dcmwijaya/Aquaponic-pH-Control-Monitoring-with-Type-2-Fuzzy-Method-Based-on-IoT-Bot/Assets/Documentation/Report/File Sidang Skripsi.pdf

Universitas Pembangunan Nasional “Veteran” Jawa Timur

# “ Kendali dan Monitoring pH Air Akuaponik Berbasis IoT Dengan Metode Fuzzy Type-2 ”

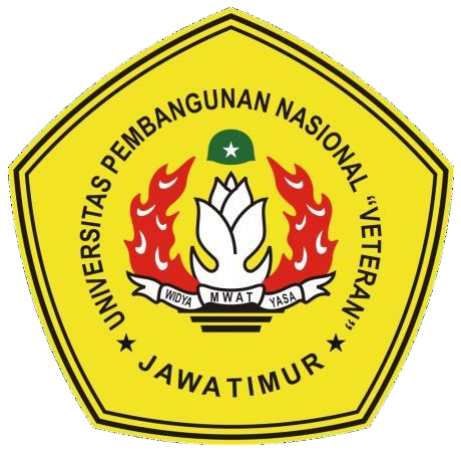
[picture p12: figure]

### Sidang Tugas Akhir (Skripsi)

Nama : Devan Cakra Mudra Wijaya

NPM : 18081010013

S1-Informatika / F. Ilmu Komputer Tahun 2022

### Dosen Pembimbing :

Dr. Basuki Rahmat, S.Si, MT •

Eva Yulia Puspaningrum, S.Kom, M.Kom •

# Latar Belakang

Covid-19 yang berlangsung di tahun 2020 menyebabkan perekonomian masyarakat global semakin menurun. Hal tersebut sangat mengkhawatirkan terutama dari sisi ketahanan pangan, sehingga masyarakat harus bergegas untuk menyelesaikan permasalahan tersebut secara mandiri. Budidaya dengan sistem akuaponik merupakan sebuah solusi alternatif yang dapat dilakukan saat ini, namun pengendalian pH sangat sulit untuk diatur yang terkadang dapat menyebabkan gagal panen. Oleh karena itu, setelah dianalisa lebih lanjut maka penulis memutuskan untuk membuat sistem pengendalian dan pemantauan keasaman air akuaponik berbasis IoT (Internet of Things) terintegrasi bot telegram dan menggunakan mikrokontroler jenis ESP32 sebagai inovasi baru. Metodologi yang diterapkan pada penelitian ini menggunakan RAD (Rapid Application Development) dengan gabungan tiga metode dalam penciptaan sistem yaitu : On-Off Controller, Fuzzy Type-2, dan Eksperimen.

# Perumusan Masalah

1. Bagaimana cara mengkategorikan derajat pH air pada sistem akuaponik berdasarkan sensor pH dan kertas lakmus ?
2. Bagaimana perancangan sistem yang memanfaatkan mikrokontroler dan internet untuk melakukan pengendalian serta pemantauan dalam jarak yang jauh ?
3. Bagaimana cara menerapkan metode Fuzzy Type-2 dalam pembuatan sistem kendali dan monitoring pH air pada sistem akuaponik ?
4. Bagaimana pengaruh pH asam terhadap pertumbuhan tanaman sawi Pakcoy dan ikan lele ?
5. Bagaimana cara mengintegrasikan perangkat mikrokontroler terhadap bot telegram ?
6. Bagaimana cara mengendalikan pH air agar dapat menjaga kondisi yang ideal dalam budidaya tanaman sawi Pakcoy dan ikan lele ?

# Batasan Masalah

1. Aplikasi terbatas untuk pengendalian dan pemantauan derajat pH air terhadap pertumbuhan tanaman sawi Pakcoy dan ikan lele pada sistem akuaponik secara realtime.
2. Media yang diperlukan untuk pengendalian dan pemantauan jarak jauh yaitu menggunakan teknologi Internet of Things.
3. Rockwool dibutuhkan sebagai media tanam hidroponik sawi Pakcoy, sedangkan akuarium dibutuhkan sebagai media akuakultur ikan lele.
4. Mikrokontroler ESP32 sebagai alat untuk memerintah sensor dan aktuator pada sistem.
5. Variabel input Fuzzy Type-2 yang ada dalam penelitian ini yaitu pHair, sedangkan variabel output-nya yaitu RelaypHup dan RelaypHdown.

# Tujuan

1. Untuk mendapatkan nilai pH air dari sensor secara realtime.
2. Untuk membandingkan tingkat keakurasian serta mengukur galat selisih dan juga galat sistematis yang ada pada sistem.
3. Untuk keperluan budidaya sayur hidroponik rumahan khususnya sawi Pakcoy dengan diiringi hobi memelihara ikan yang menggunakan teknologi IoT (Internet of Things).
4. Untuk membuat sistem pengendalian dan pemantauan keasaman air akuaponik yang mudah digunakan oleh pengguna aplikasi (user friendly) kapanpun dan dimanapun berada.
5. Untuk membuat inovasi yang unik berupa perancangan sistem yang bertujuan untuk menyelesaikan masalah ketahanan pangan di masa pandemi COVID-19 dalam skala kecil (konsumsi pribadi).

# Manfaat

1. Bagi Peneliti, kegiatan ini memberikan dorongan positif untuk menerapkan ilmu yang telah

dipelajari semasa kuliah khususnya di bidang sistem cerdas robotika (sistem kontrol).

2. Bagi Masyarakat Umum, dapat menjadi referensi unik dalam pembudidayaan sayur dan

ikan melalui sistem akuaponik yang berbasis teknologi.

3. Bagi Pembaca, dapat mempelajari dan memahami konsep rancang bangun aplikasi berbasis

Internet of Things dan juga dapat mempermudah pemahaman terkait penggunaan bot

telegram.

# Penelitian Terdahulu

1. Mailoa dkk, 2020. “ Sistem Kontrol dan Monitoring Kadar pH Air pada Sistem Akuaponik Berbasis NodeMCU ESP8266 Menggunakan Telegram ” : Peneliti membuat prototipe hardware dan software (bot telegram) agar dapat mengontrol dan memantau kadar pH air pada sistem akuaponik.
2. Alam dkk, 2020. “ Sistem Pengendali pH Air dan Pemantauan Lingkungan Tanaman Hidroponik menggunakan Fuzzy Logic Controller berbasis IoT ” : Peneliti membuat prototipe hardware dan software (blynk) untuk mengontrol pH air dan memonitor lingkungan tanaman hidroponik berbasis Internet of Things (IoT).
3. Yunior dkk, 2019. “ Sistem Monitoring Kualitas Air pada Budidaya Perikanan Berbasis IoT dan Manajemen Data ” : Peneliti membuat prototipe hardware dan software (website dan mobile application) untuk mengantisipasi penyakit dan bakteri yang ada pada air kolam budidaya dengan meningkatkan kualitas air (pH, oksigen terlarut, suhu, dan kekeruhan).
4. Haqim dkk, 2018. “ Perancangan Web Monitoring dan Kontrolling Aquaponic Untuk Budidaya Ikan Lele Berbasis Internet of Things ” : Peneliti membuat prototipe hardware dan software (website) agar dapat memantau kondisi pH dan suhu air sewaktu-waktu. Selain itu juga untuk mengontrol pemberian pakan ikan dari jarak yang jauh.

1

2
3

4

# Sejarah Fuzzy

Tahun 1930-an | Tahun 1965 | Tahun 1975 | Tahun 1998
Logika Infinity diperkenalkan oleh Łukasiewicz dan Tarski | Logika Fuzzy Type-1 diperkenalkan oleh Lotfi Aliasker Zadeh | Logika Fuzzy Type-2 diperkenalkan oleh Lotfi Aliasker Zadeh | Teori Logika Fuzzy diperjelas lagi oleh Karnik-Mendel, sehingga menjadi populer

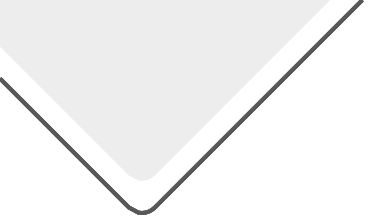
[picture p13: figure]

# Cara Kerja Fuzzy Type-2

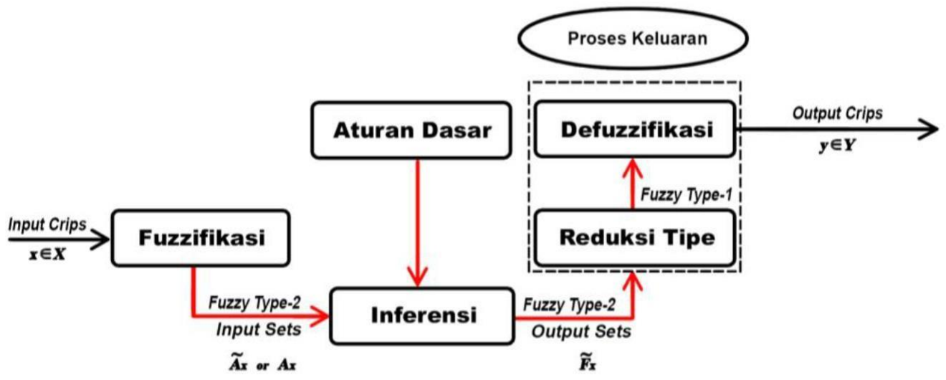
[picture p14: figure]

Fuzzifikasi = proses memetakan input crips menjadi nilai keanggotaan
linguistik (UMF dan LMF).
Inferensi | = proses | memetakan | basis
aturan | logika | pada | hasil
fuzzifikasi.

Reduksi Tipe = proses mengubah himpunan
fuzzy | type-2 | menjadi
himpunan fuzzy type-1.

Defuzzifikasi = proses untuk mengolah hasil reduksi tipe menjadi nilai tegas (crips) sebagai hasil akhir (output).

# Istilah Dalam Logika Fuzzy

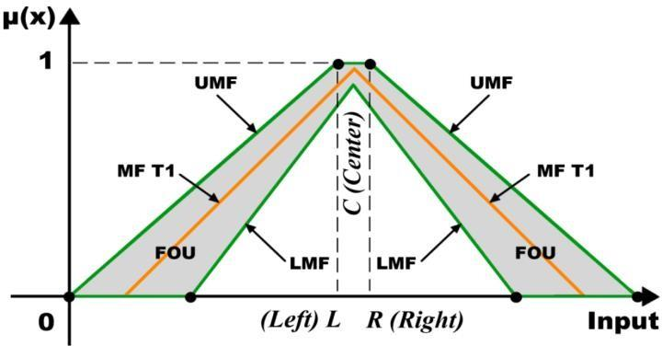
[picture p15: figure]

Variabel | = berupa input atau output Fuzzy.

Himpunan Fuzzy = kumpulan data berupa
| linguistik dan numeris.
Himpunan Crips | = kumpulan data berupa nilai tegas (1/0).
Domain | = range nilai pada suatu himpunan Fuzzy.

Himpunan Semesta = range nilai pada variabel Fuzzy.
Fungsi Keanggotaan = pemetaan | titik | input
Fuzzy berdasarkan kurva.
FOU | = wilayah terbatas.
UMF | = himpunan atas.
LMF | = himpunan bawah.

# Representasi Kurva

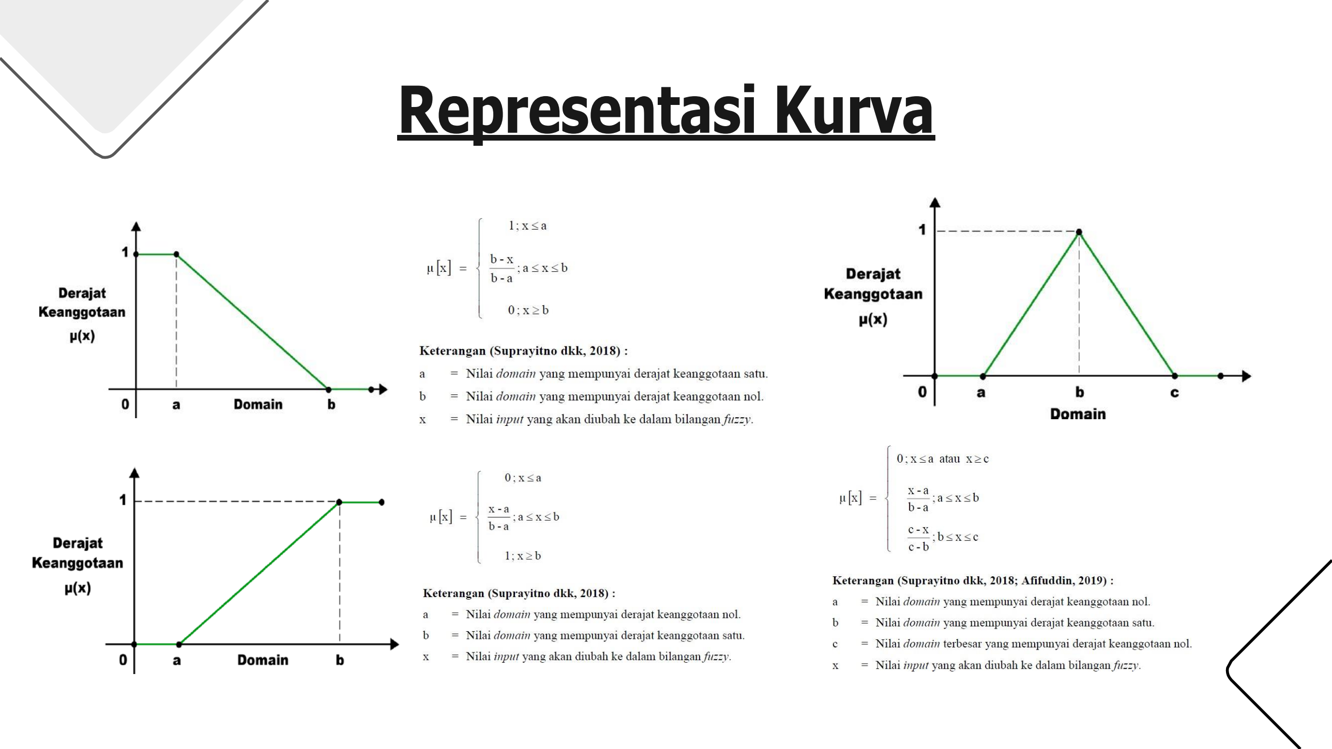
[picture p16: page 11]

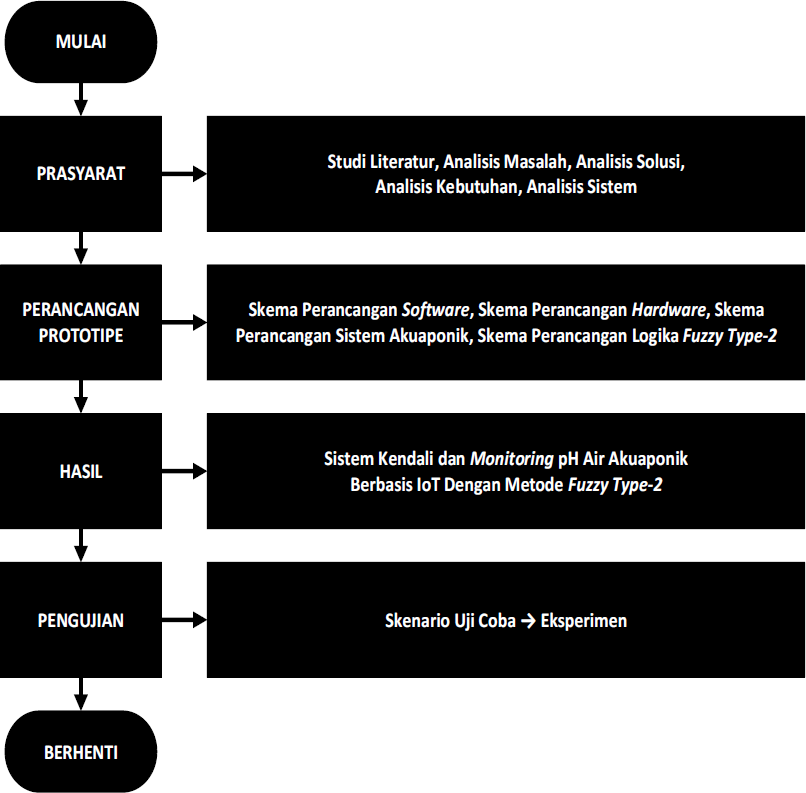
[picture p17: figure]

# Metode Penelitian

Metodologi yang digunakan pada penelitian ini berupa RAD (Rapid Application Development). Hal tersebut
mempunyai | 4 | tahapan | dalam
pelaksanaannya | yaitu | prasyarat
(requirement), perancangan prototipe (prototyping), hasil (output), dan pengujian (testing). Hal tersebut dapat anda lihat pada Gambar di samping.

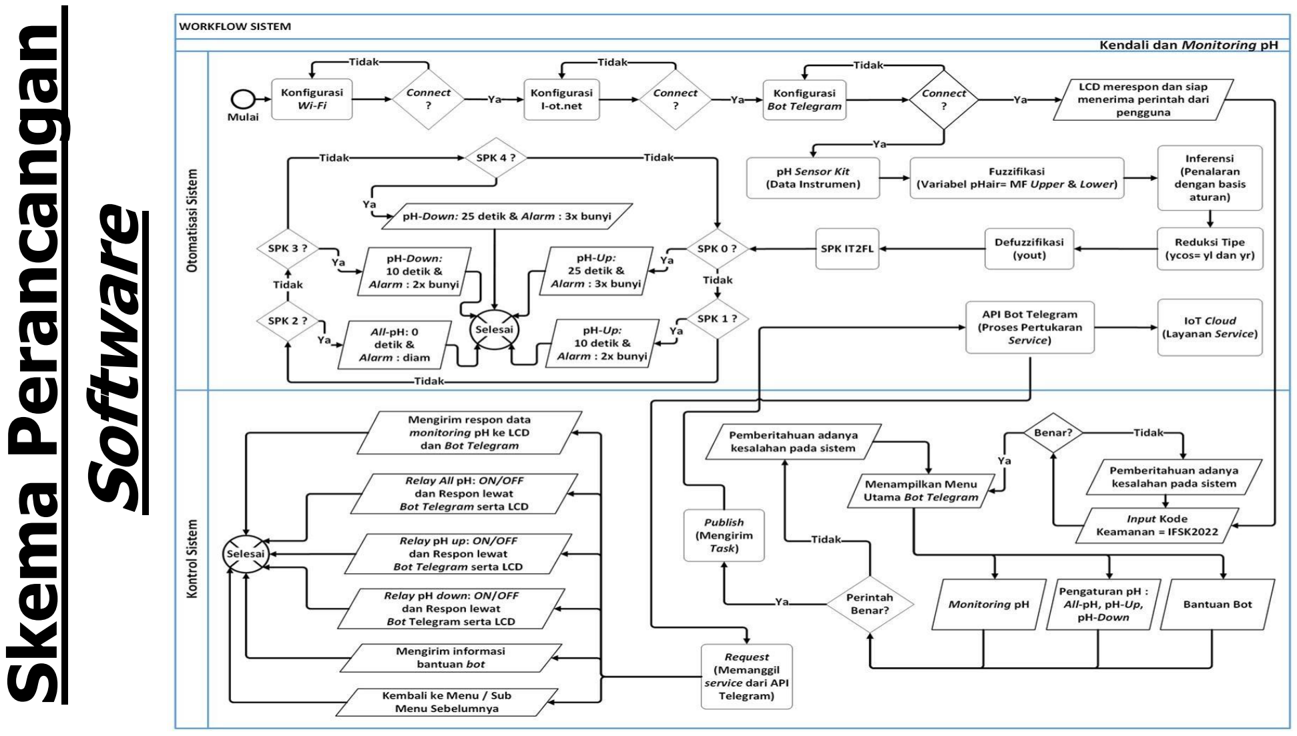
[picture p18: page 13]

# Skema Perancangan

# Software

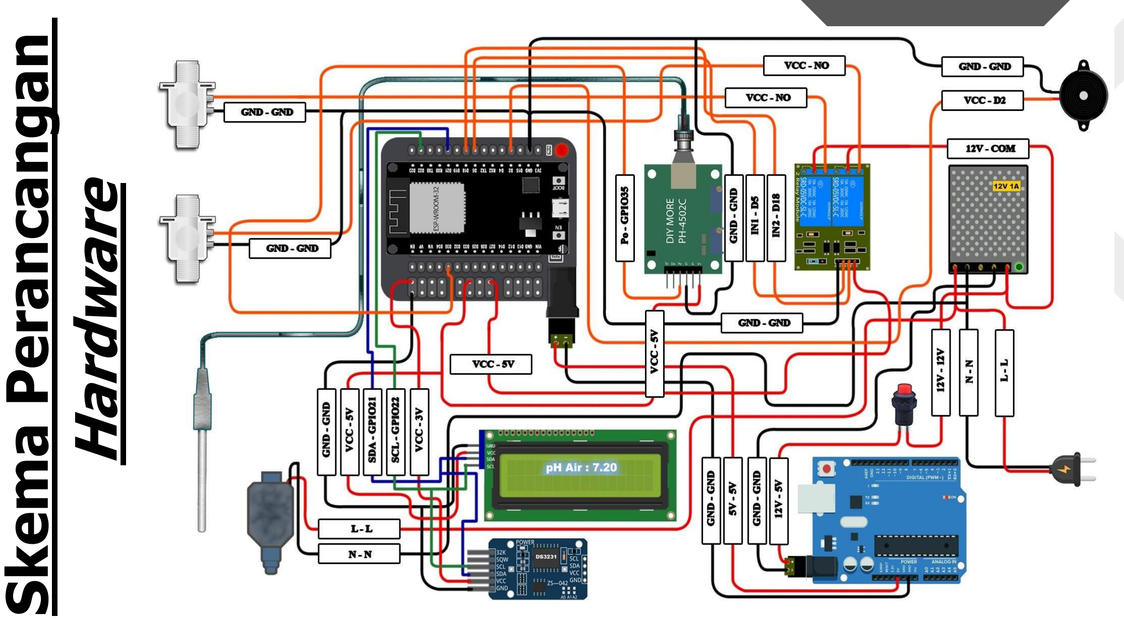
[picture p19: page 14]

# Skema Perancangan

# Hardware

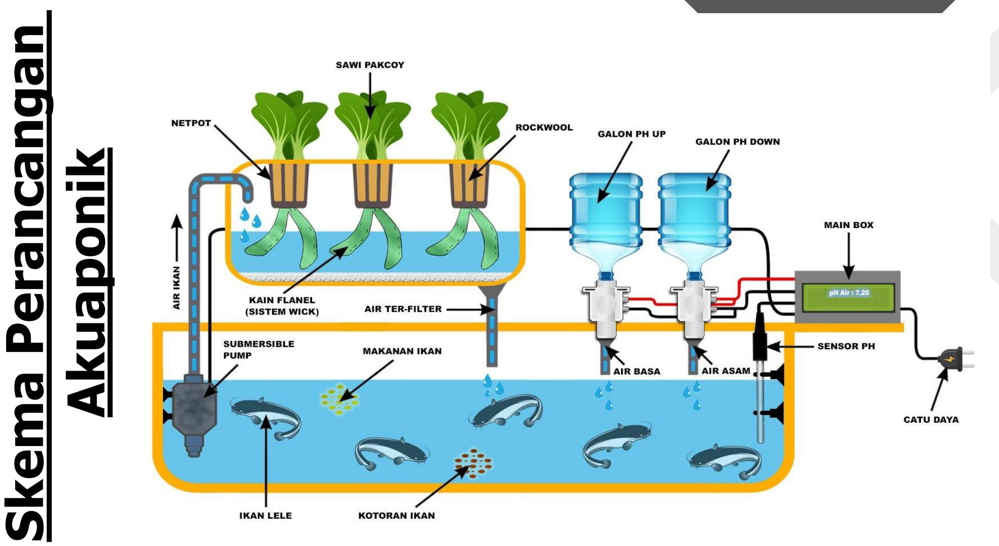
[picture p20: page 15]

# Skema Perancangan

# Akuaponik

# Skema Perancangan Logika Fuzzy Type-2

Pada penelitian ini, logika fuzzy type-2 yang diterapkan berupa IT2FL yang dipakai penulis untuk sistem kendali dan monitoring pH air akuaponik. Hal tersebut dapat mengendalikan pH air sehingga mencapai kondisi yang ideal dalam budidaya tanaman sawi Pakcoy dan ikan lele. Adapun tahapan-tahapan dalam perancangan logika fuzzy type-2 yaitu dapat dilakukan sebagai berikut ini :

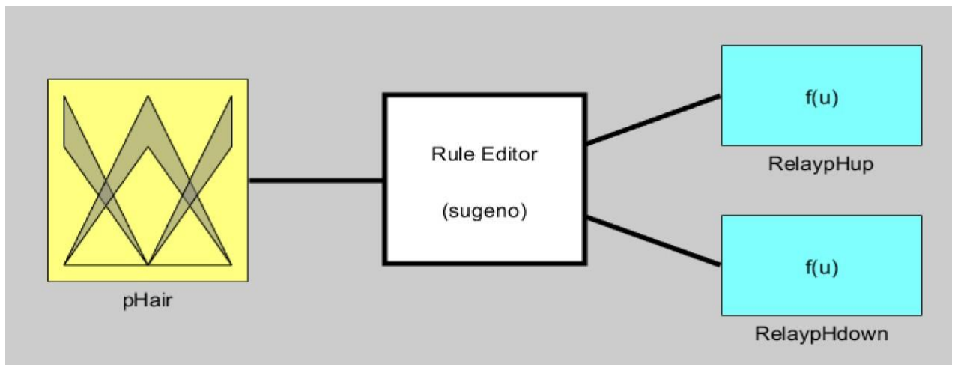
[picture p21: figure]

Fuzzifikasi

Model FIS yang digunakan oleh
penulis yaitu SIMO (Single Input Multi Output). Variabel input yang dipakai dalam penelitian ini hanya variabel pHair, sedangkan variabel
output | yang | dipakai | dalam
penelitian ini ada dua yaitu variabel RelaypHup dan RelaypHdown.

# Fuzzifikasi : Variabel Input

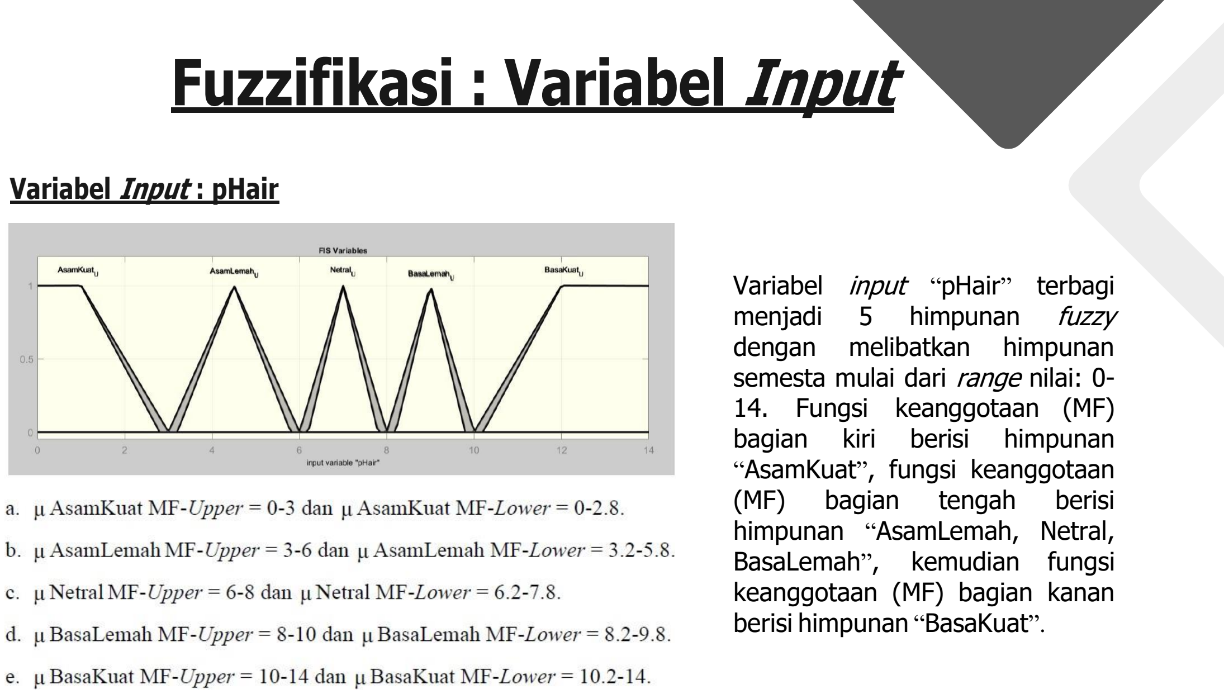
[picture p22: page 17]

Variabel Input : pHair

Variabel input “pHair” terbagi
menjadi | 5 | himpunan | fuzzy
dengan | melibatkan | himpunan
semesta mulai dari range nilai: 0-
14. Fungsi keanggotaan (MF)
bagian | kiri | berisi | himpunan
“AsamKuat”, fungsi keanggotaan
(MF) | bagian | tengah | berisi
himpunan “AsamLemah, Netral, BasaLemah”, kemudian fungsi keanggotaan (MF) bagian kanan berisi himpunan “BasaKuat”.

# Fuzzifikasi: MF Variabel Input

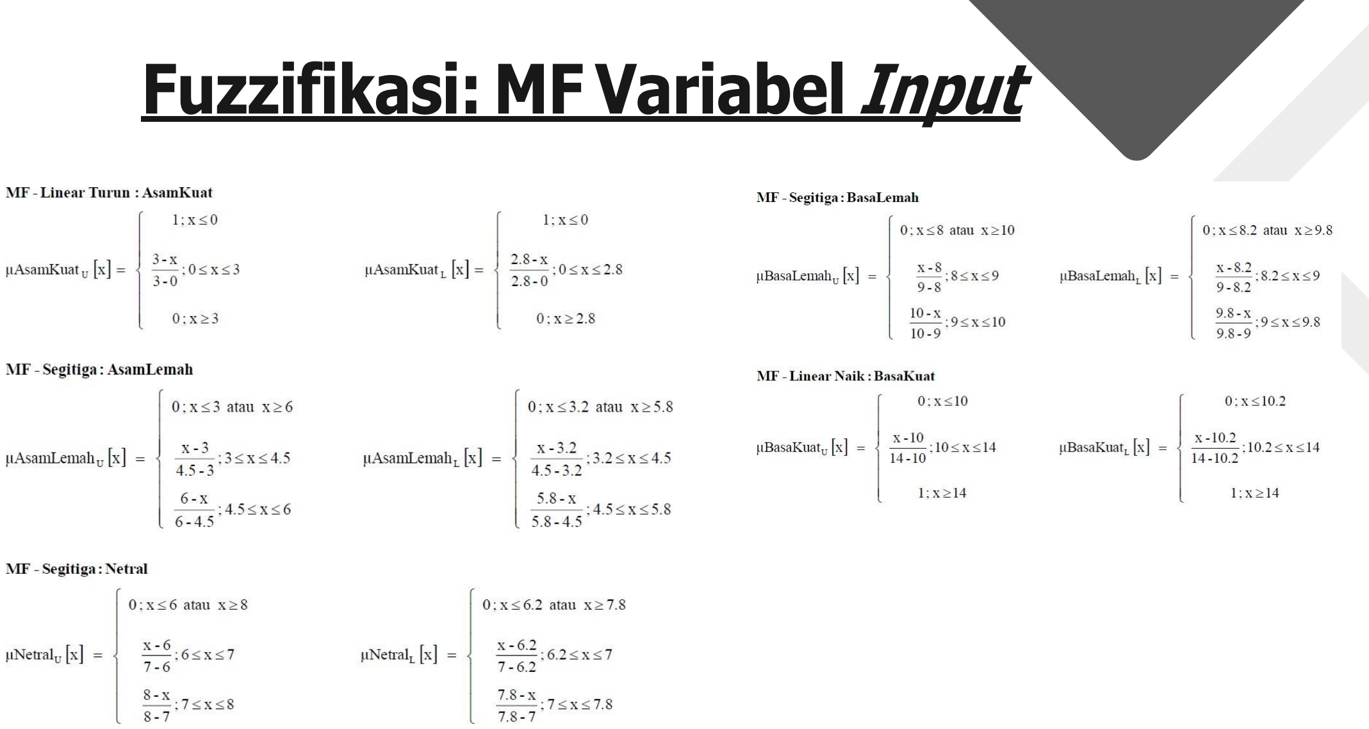
[picture p23: page 18]

# Fuzzifikasi : Variabel Output

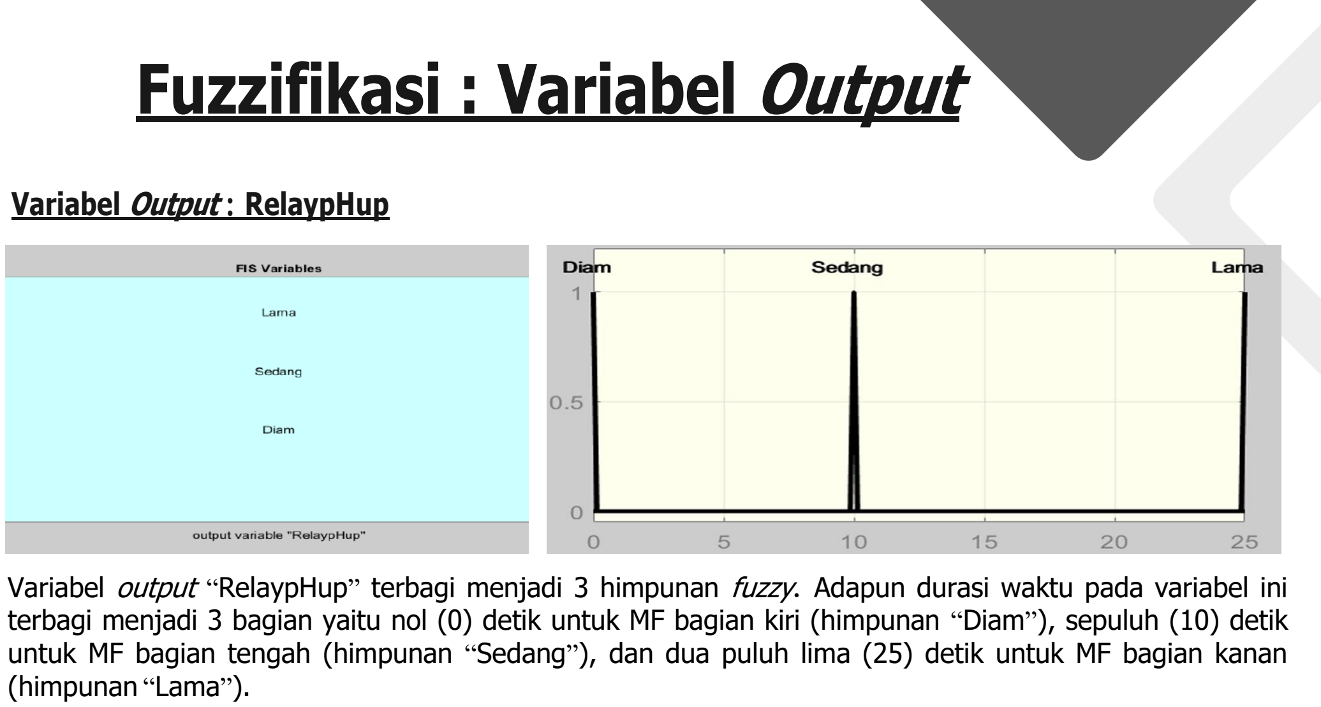
[picture p24: page 19]

Variabel Output : RelaypHup

Variabel output “RelaypHup” terbagi menjadi 3 himpunan fuzzy. Adapun durasi waktu pada variabel ini terbagi menjadi 3 bagian yaitu nol (0) detik untuk MF bagian kiri (himpunan “Diam”), sepuluh (10) detik untuk MF bagian tengah (himpunan “Sedang”), dan dua puluh lima (25) detik untuk MF bagian kanan (himpunan “Lama”).

# Fuzzifikasi : Variabel Output

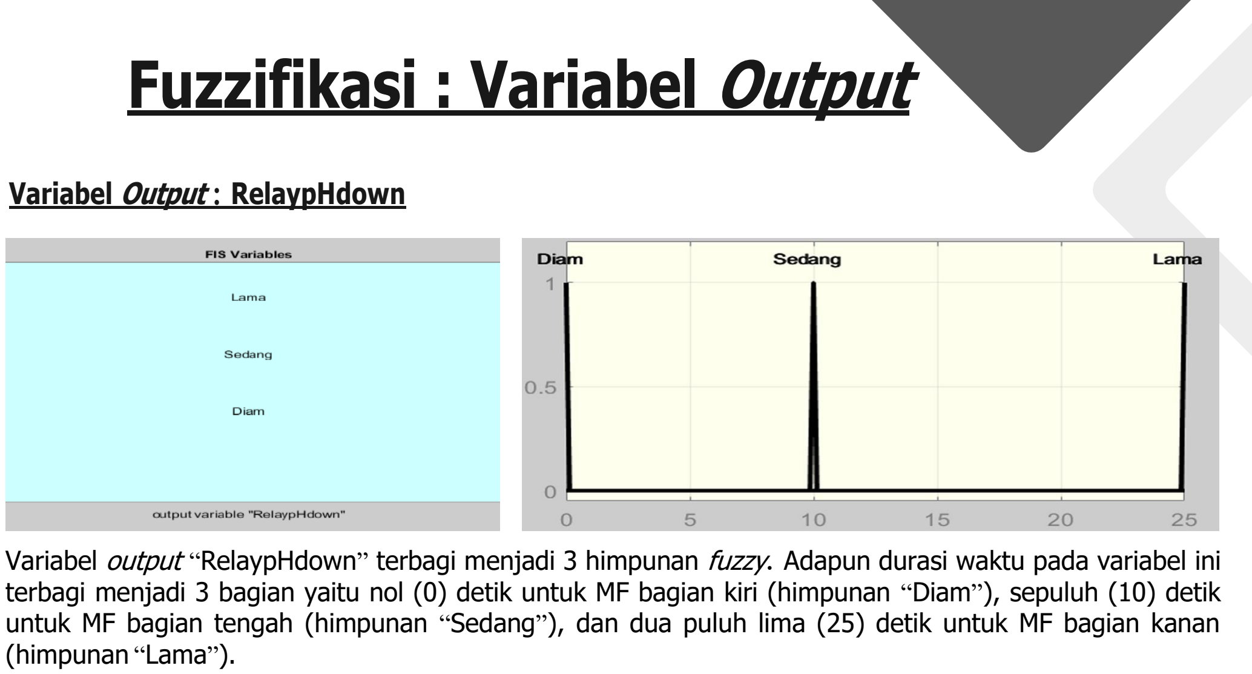
[picture p25: page 20]

Variabel Output : RelaypHdown

Variabel output “RelaypHdown” terbagi menjadi 3 himpunan fuzzy. Adapun durasi waktu pada variabel ini terbagi menjadi 3 bagian yaitu nol (0) detik untuk MF bagian kiri (himpunan “Diam”), sepuluh (10) detik untuk MF bagian tengah (himpunan “Sedang”), dan dua puluh lima (25) detik untuk MF bagian kanan (himpunan “Lama”).

# Inferensi Fuzzy Type-2

Pada inferensi ini, pengambilan keputusan pada sistem didasari oleh ketetapan-ketetapan berikut ini :

1. Nilai output sama dengan nol (0), maka perintah yang wajib dilakukan yaitu RelaypHup : ON lama (25 detik) dan RelaypHdown : OFF.
2. Nilai output sama dengan satu (1), maka perintah yang wajib dilakukan yaitu RelaypHup : ON sedang (10 detik) dan RelaypHdown : OFF.

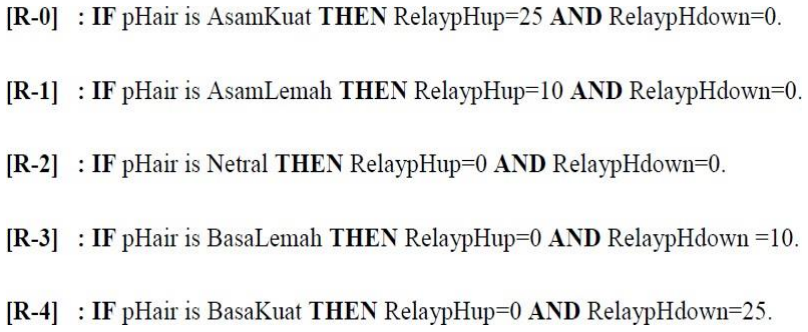
[picture p26: figure]

3. Nilai output sama dengan dua (2), maka perintah yang wajib dilakukan yaitu RelaypHup : OFF dan RelaypHdown : OFF.
4. Nilai output sama dengan tiga (3), maka perintah yang wajib dilakukan yaitu RelaypHup : OFF dan RelaypHdown : ON sedang (10 detik).
5. Nilai output sama dengan empat (4), maka perintah yang wajib dilakukan yaitu RelaypHup : OFF dan RelaypHdown :ON lama (25 detik).

Pada penelitian ini, variabel pHair diketahui ada 5 himpunan fuzzy yang setelah melalui proses penalaran mendapatkan 5 kombinasi aturan (rule) yang dapat diterapkan pada
sistem. | Inferensi | dalam | penelitian | ini
menggunakan Metode Sugeno Orde-Nol
dengan | penalaran | monoton, | karena
proposisi | terhitung | tunggal | di | bagian
antesedennya.

# Reduksi Tipe dan Defuzzifikasi Fuzzy Type-2

Pada penelitian ini, penulis menggunakan jenis reduksi tipe : Center of Set (KM-Algorithm). Bentuk umum dari Center of Set Typereduction untuk sistem kontrol dapat anda lihat pada persamaan berikut.

Adapun rumus deffuzifikasi yang ada pada IT2FL ditunjukkan pada persamaan berikut.

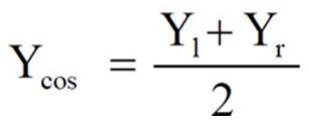
[picture p27: figure]
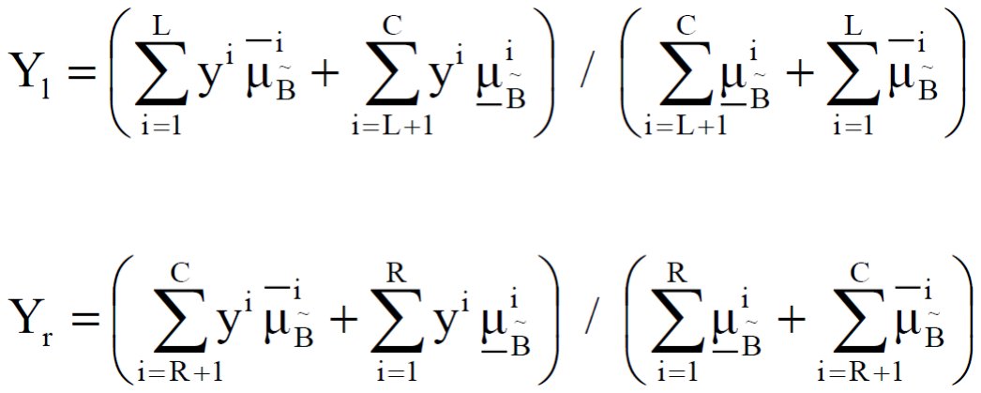
[picture p28: figure]

# Contoh Manual : Fuzzifikasi Fuzzy Type-2

Diketahui sensor pH milik Pak Jojo menunjukkan nilai pH sebesar 8.5, maka bagaimana cara menentukan hasil fuzzy ?

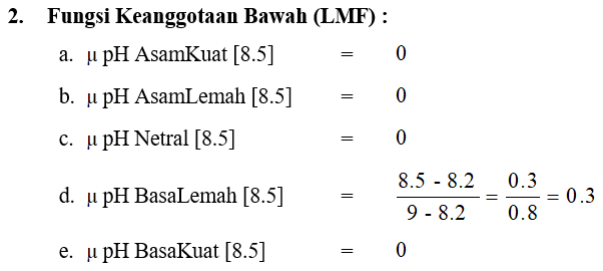
[picture p29: figure]
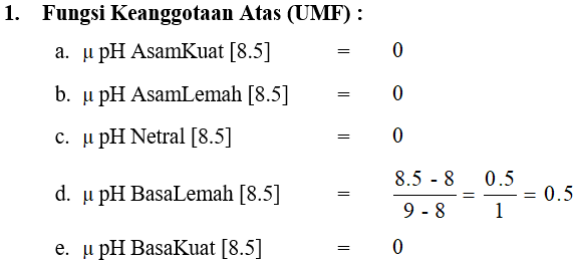
[picture p30: figure]

# Contoh Manual : Inferensi Fuzzy Type-2

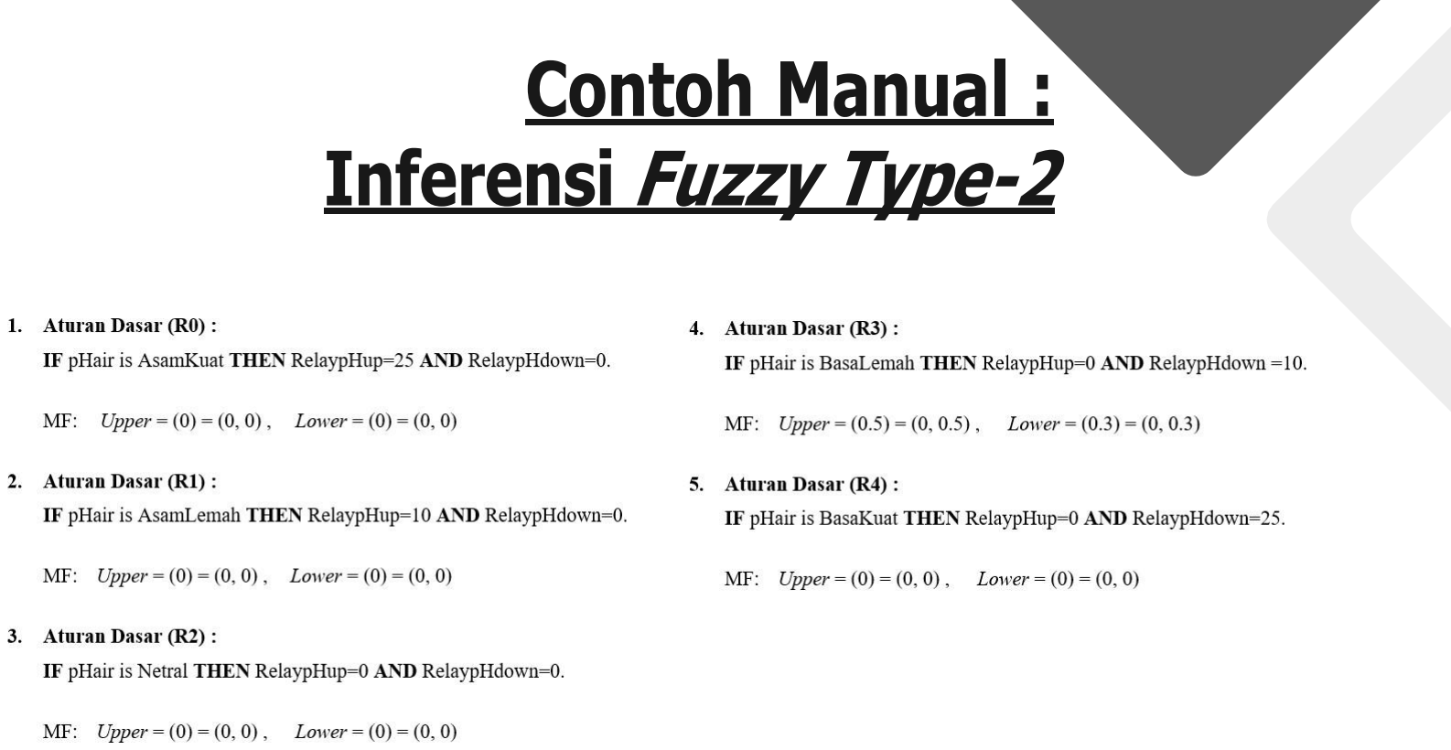
[picture p31: page 24]

# Contoh Manual : Reduksi Tipe Fuzzy Type-2

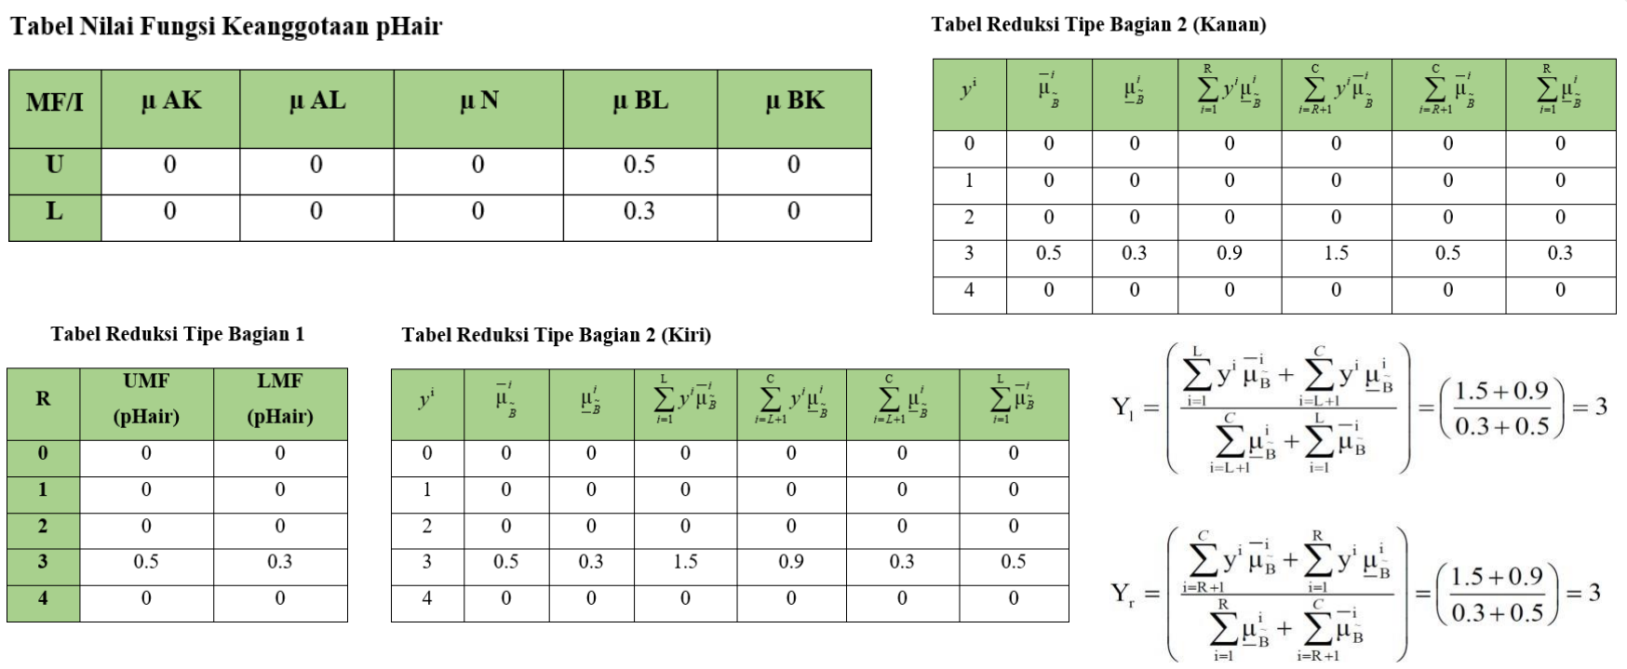
[picture p32: figure]

# Contoh Manual : Defuzzifikasi Fuzzy Type-2

Selanjutnya dapat dilakukan proses defuzzifikasi dengan cara mengambil nilai rata-rata (average) dari himpunan interval kiri (yl) dan kanan (yr). Berikut merupakan contoh penyelesaian defuzzifikasi :

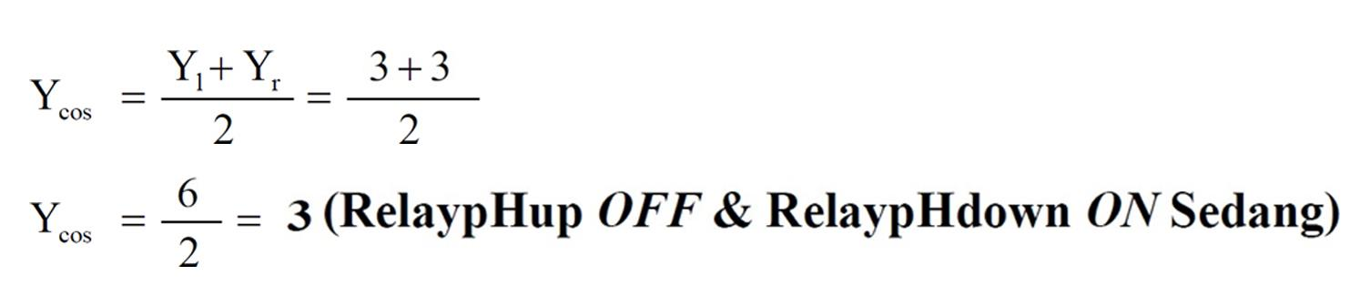
[picture p33: figure]

# Integrasi : Internet of Things

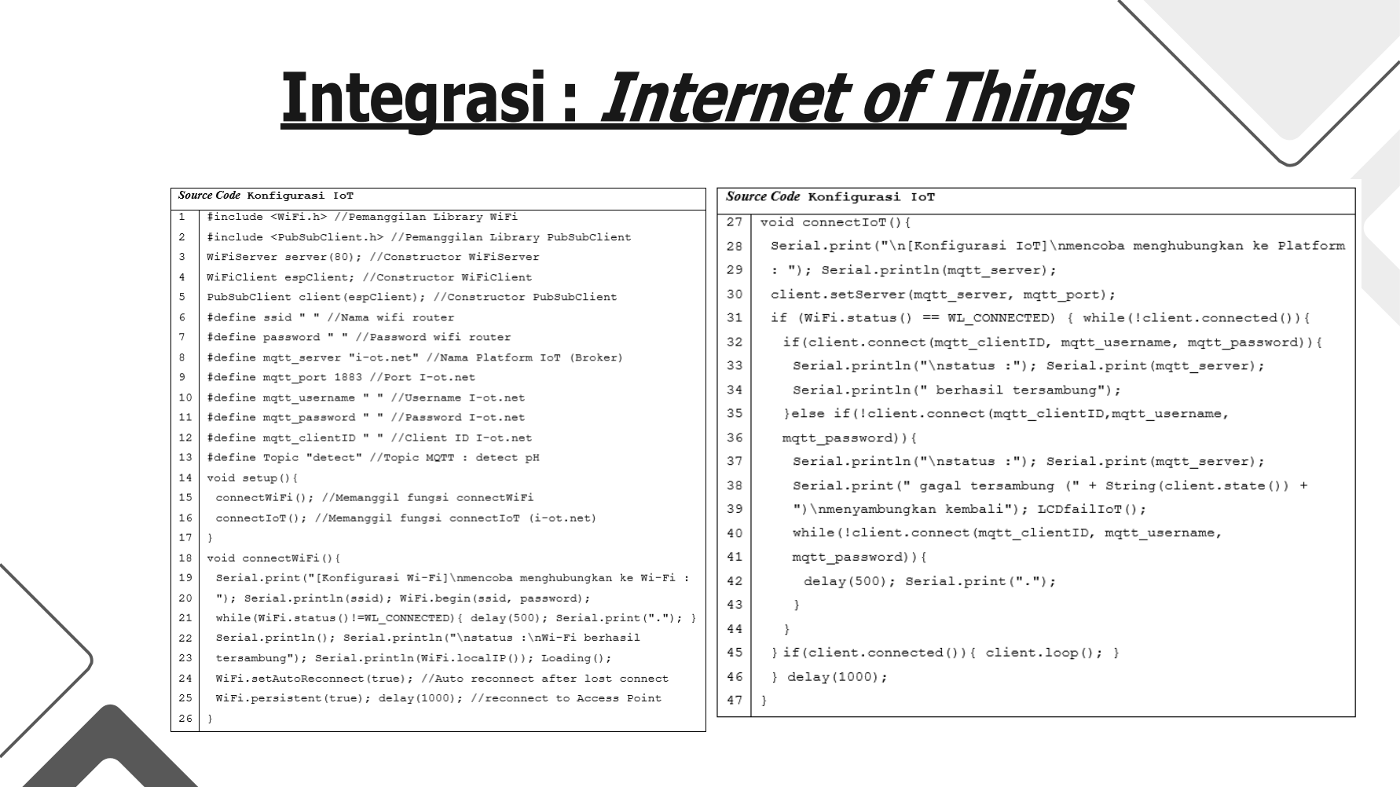
[picture p34: page 27]

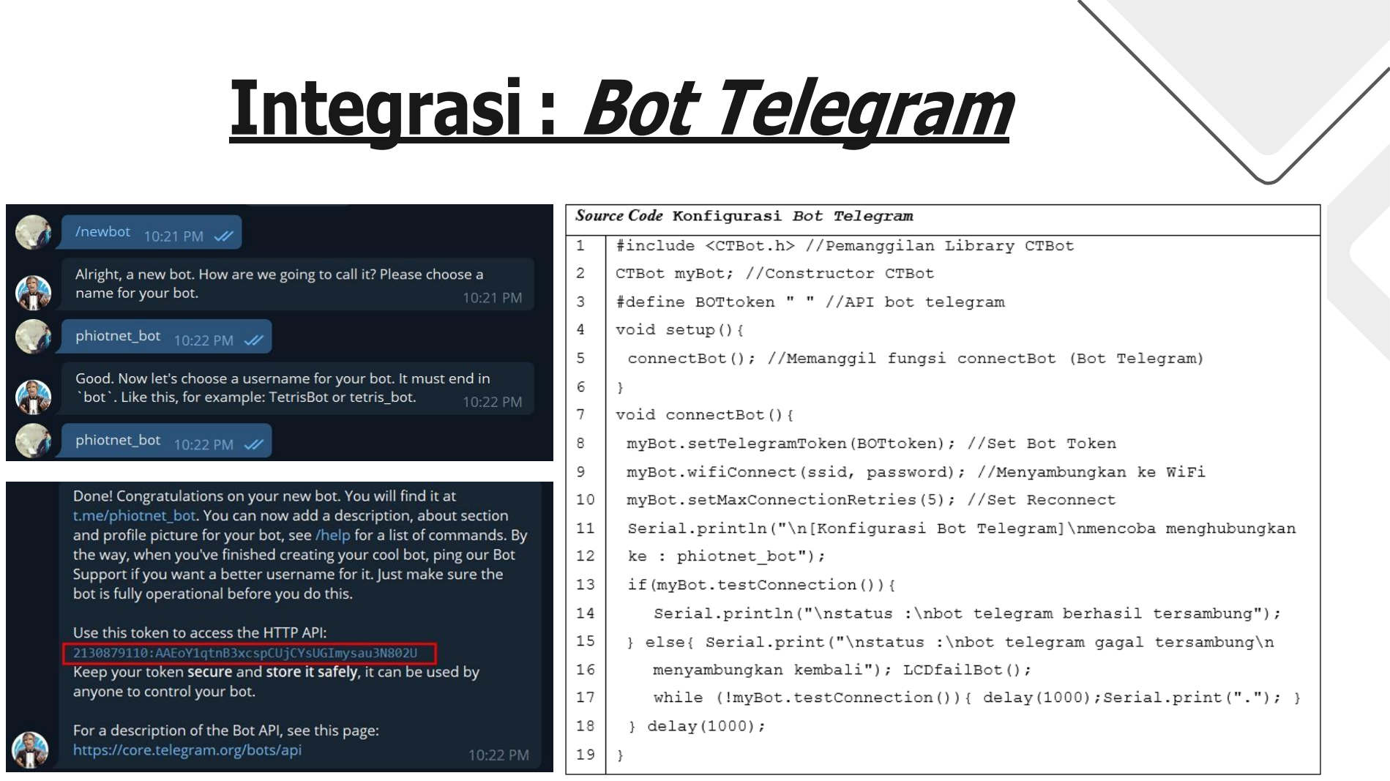
[picture p35: figure]
Integrasi : Bot Telegram

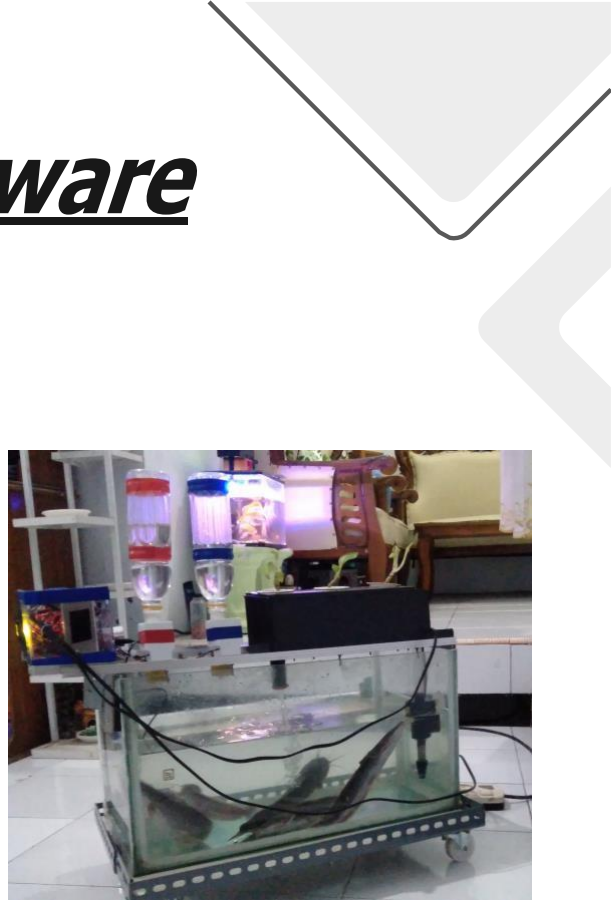
[picture p36: figure]

# Hasil: Rancangan Hardware

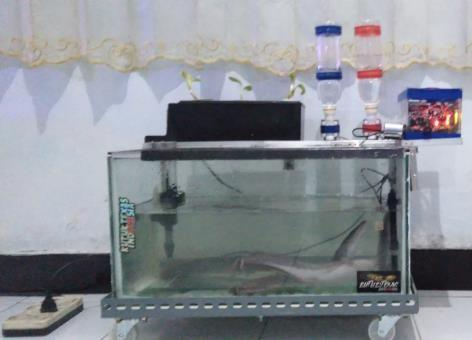
[picture p37: figure]

Rangkaian ini terdiri atas:

- 1 Arduino Uno.
- 1 ESP32.
- 1 ESP32 Baseboard.
- 1 Electrical Relay Module.
- 2 Pneumatic Solenoid Valve.
- 1 LCD I2C.
- 1 RTC (Real Time Clock) Module.
- 1 Electrical Piezo Buzzer.
- 1 PH Sensor Kit.
- 1 Switching Power Supply.
- 1 Submersible Pump.

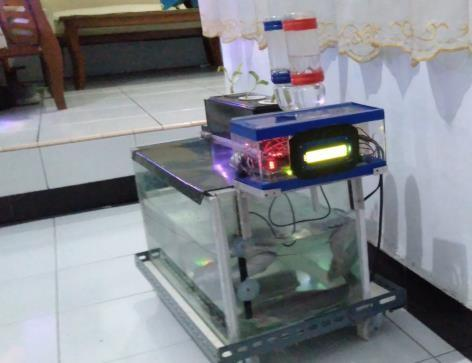
[picture p38: figure]

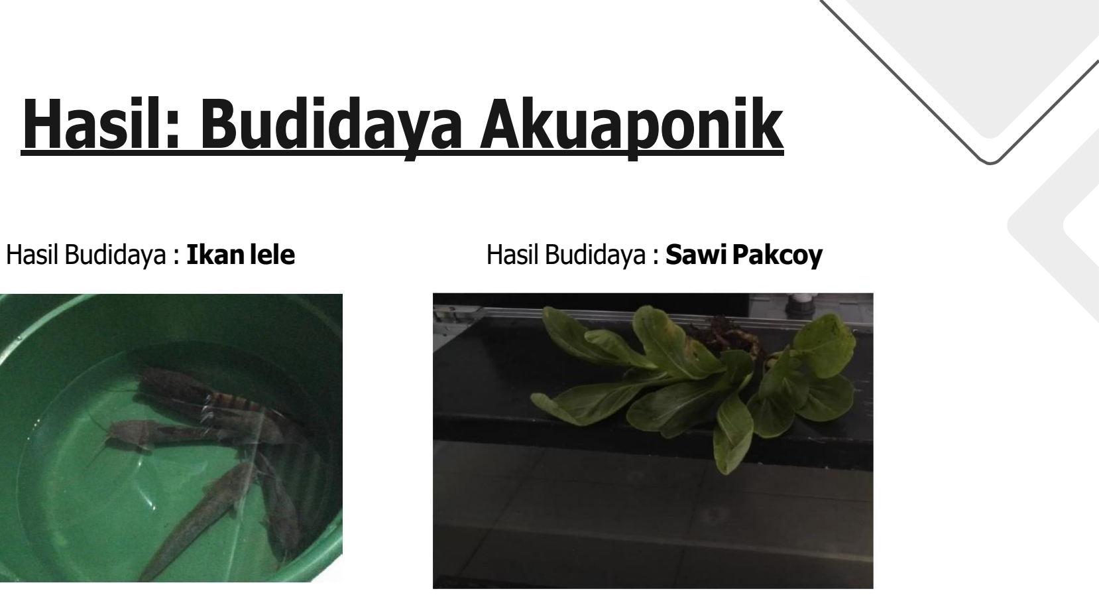
[picture p39: figure]
Hasil: Budidaya Akuaponik; Hasil Budidaya : Ikan lele; Hasil Budidaya : SawiPakcoy
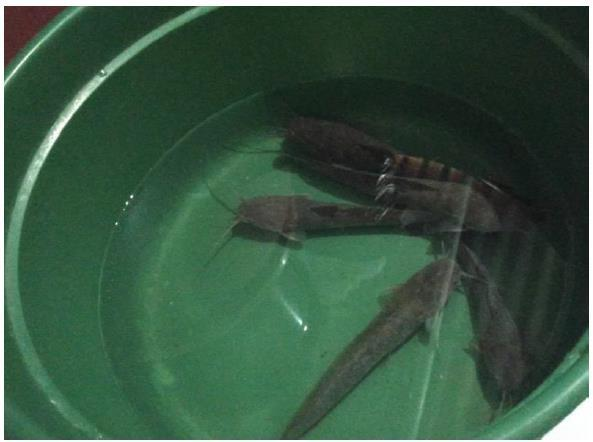
[picture p40: figure]

Rentang waktu panen ikan lele :

### 2 hingga 3 bulan

Rentang waktu panen sawi pakcoy :

### 1 hingga 2 bulan

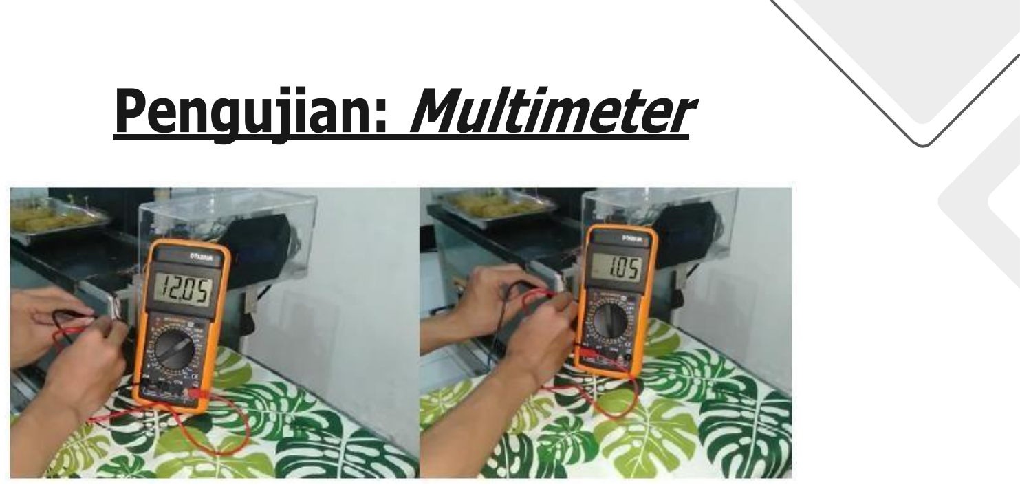
[picture p41: figure]
Pengujian: Multimeter

Gambar di atas menunjukkan proses pengujian sampel tegangan dan kuat arus pada hardware. Dalam pengujian tersebut, hardware yang ada diukur dengan menggunakan alat multimeter. Dengan adanya pengujian ini, sehingga dapat diketahui pembagian tegangan operasi yang digunakan pada sistem dapat berjalan sesuai rancangan.

# Pengujian: Kertas Lakmus

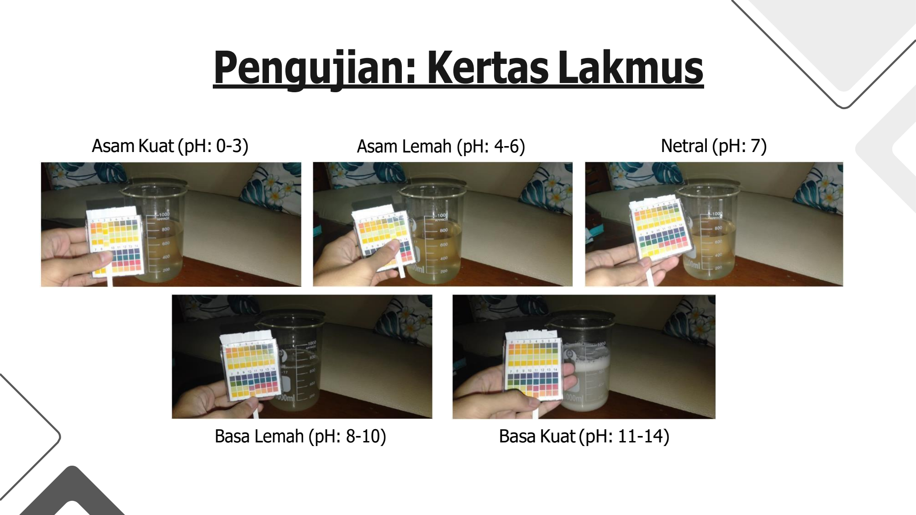
[picture p42: page 32]

Asam Kuat (pH: 0-3) | Asam Lemah (pH: 4-6) | Netral (pH: 7)
Basa Lemah (pH: 8-10) | Basa Kuat(pH: 11-14)

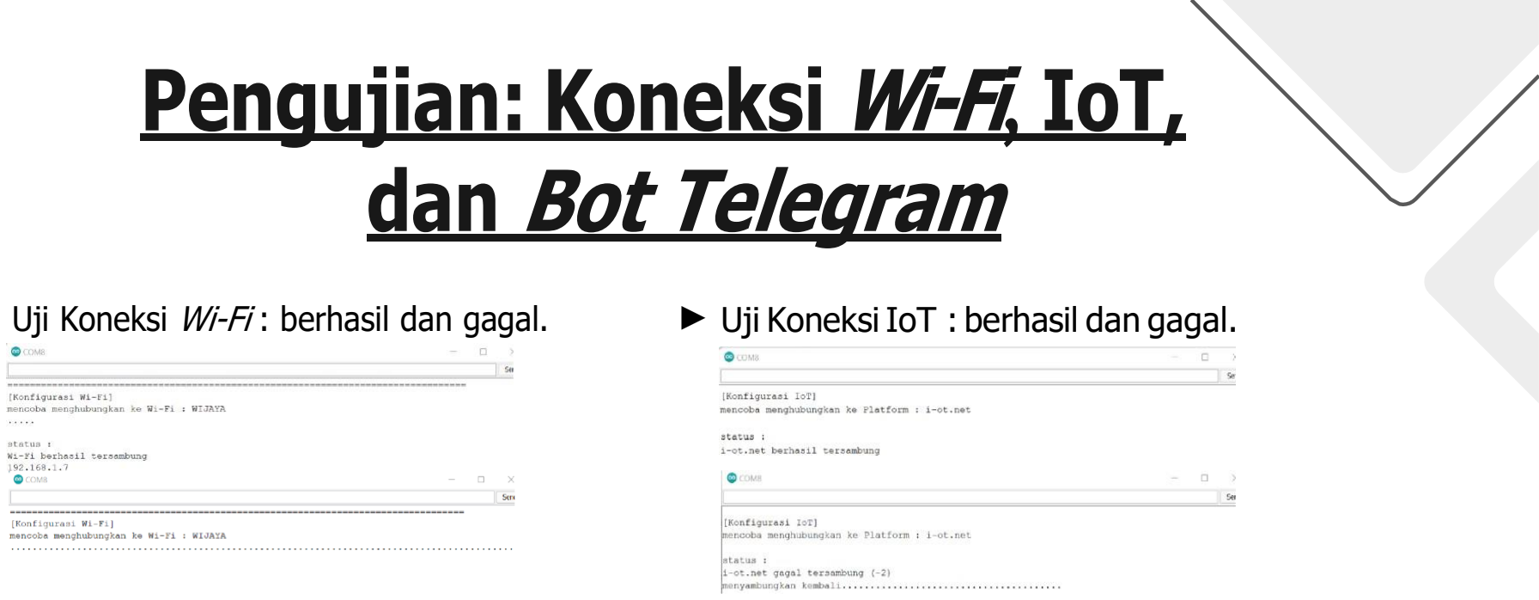
[picture p43: figure]
Pengujian: Koneksi Wi-Fi, IoT, dan Bot Telegram

- Uji Koneksi Wi-Fi : berhasil dan gagal. | ► Uji KoneksiIoT : berhasil dan gagal.

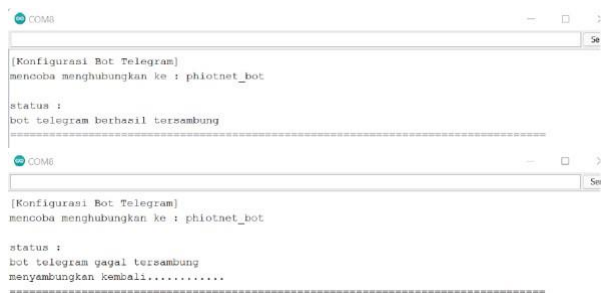
[picture p44: figure]

- Uji Koneksi Bot Telegram : berhasil dan gagal.

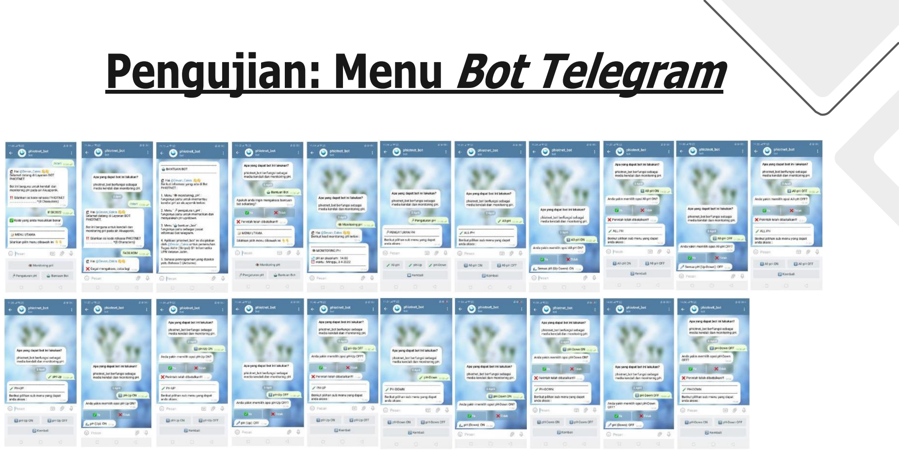
[picture p45: figure]
Pengujian: Menu Bot Telegram

# Pengujian: Monitoring pH dan Pengaruh pH Asam

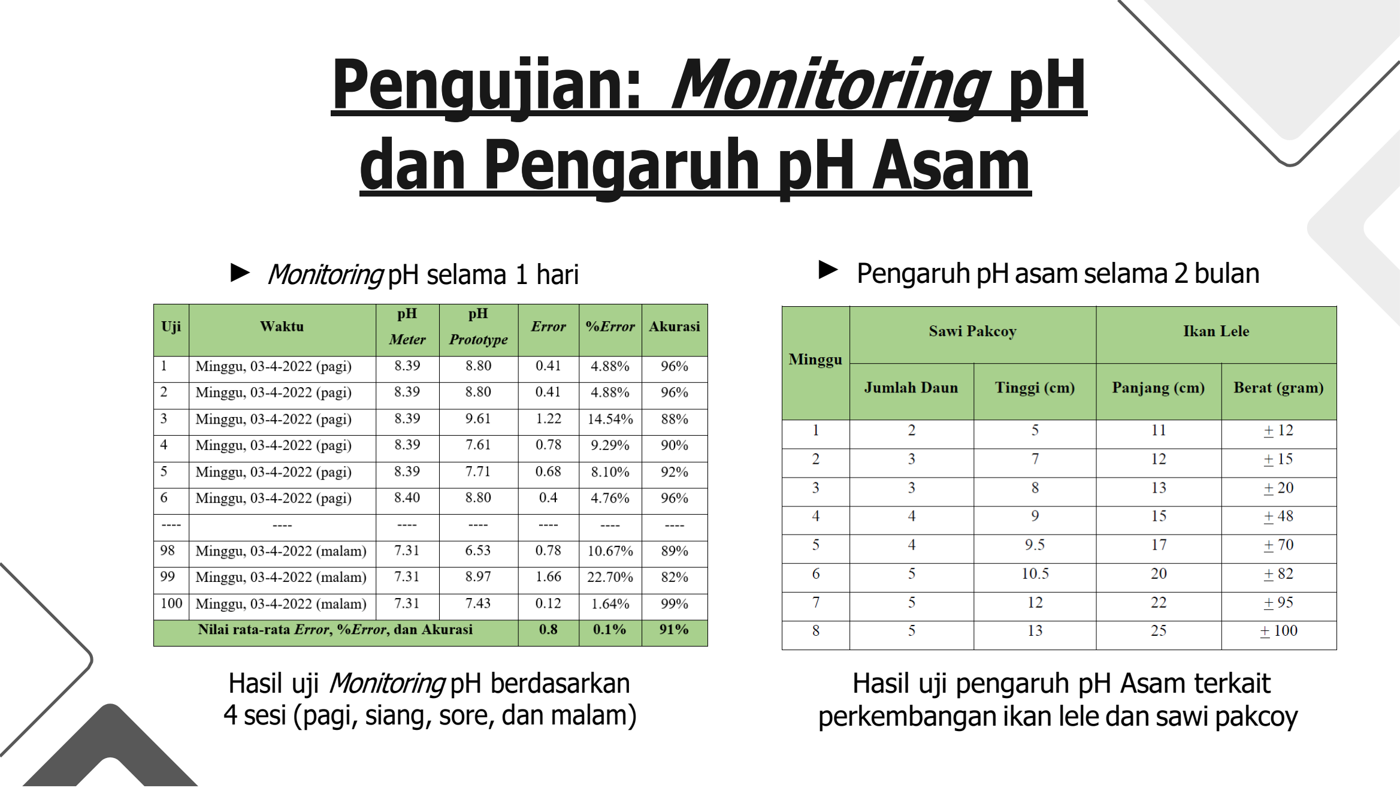
[picture p46: page 35]

- Monitoring pH selama 1 hari | ► Pengaruh pH asam selama 2 bulan

Hasil uji Monitoring pH berdasarkan 4 sesi (pagi, siang, sore, dan malam)

Hasil uji pengaruh pH Asam terkait perkembangan ikan lele dan sawi pakcoy

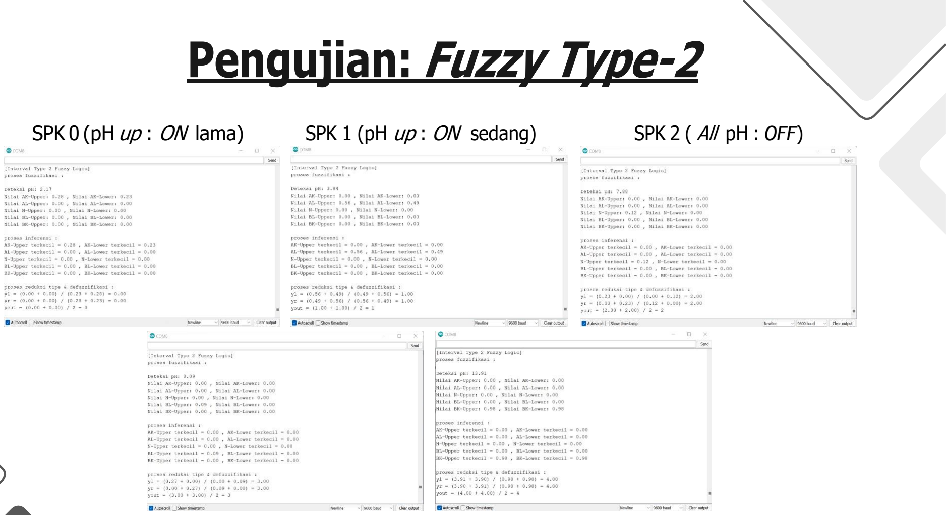
[picture p47: figure]
Pengujian: Fuzzy Type-2

SPK 0 (pH up : ON lama) | SPK 1 (pH up : ON sedang) | SPK 2 ( All pH : OFF)
SPK 3 (pH down : ON sedang) | SPK 4 (pH down : ON lama)

# KESIMPULAN

1. Dalam penelitian ini, metodologi yang dipakai ialah RAD (Rapid Application Development), sedangkan metode yang digunakan meliputi : On-Off Controller, Fuzzy Type-2, dan Eksperimen.
2. Dalam sistem akuaponik, derajat pH yang ideal bagi ikan lele dan Sawi Pakcoy ialah di kisaran pH 5-8. Lalu Sawi Pakcoy dapat dipanen kurang lebih 2 bulan, sedangkan ikan lele waktu panen kurang lebih 2 sampai 3 bulan.
3. Pengkategorian pH dibagi menjadi : Asam Kuat (0-3), Asam Lemah (4-6), Netral (7), Basa Lemah (8-10), dan Basa Kuat (11-14).
4. Pada sistem ini, suplai listrik dan internet wajib ada karena sebagai modal awal untuk beroperasi. Lalu, integrasi sistem menggunakan bot telegram yang mana sangat mudah diaplikasikan baik kapanpun dan dimanapun berada sehingga dapat membantu dalam meningkatkan ketahanan pangan pada level rumah tangga di masa Pandemi Covid-19 ini.
5. Logika Fuzzy Type-2 yang diimplementasikan berjenis Interval, yang mana mampu dalam mengatasi ketidakpastian yang ada pada sistem kendali pH air, sehingga pH air tetap optimal. Hal tersebut dilakukan secara otomatis.
6. Berdasarkan hasil pengujian, sistem yang dibuat ini dapat berjalan dengan baik dan telah valid yang ditunjukkan oleh adanya kesesuaian antara sistem dengan requirement. Lalu galat selisih rata-rata yang ada pada sensor sebesar 0,8. Sedangkan galat sistematis rata-rata yang ada pada sensor sebesar 0,1%. Kemudian, akurasi rata-rata yang ada pada sensor sebesar 91%.

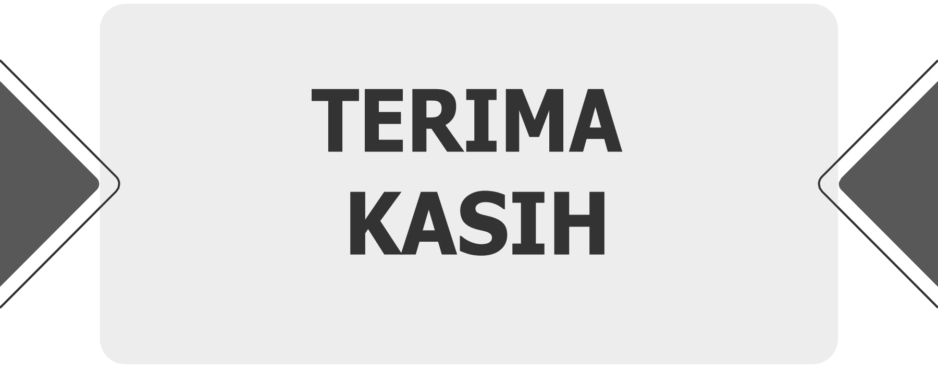
[picture p48: figure]
TERIMA KASIH
