dcmwijaya/Aquaponic-pH-Control-Monitoring-with-Type-2-Fuzzy-Method-Based-on-IoT-Bot/Assets/Documentation/Diagram/DiagramBlock.jpg

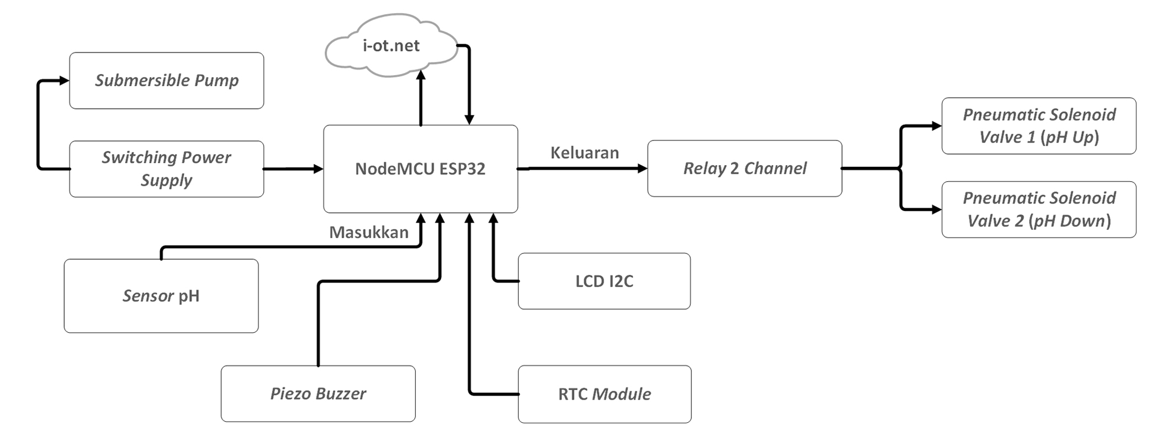
Assets/Documentation/Diagram/DiagramBlock.jpg
