dcmwijaya/Aquaponic-pH-Control-Monitoring-with-Type-2-Fuzzy-Method-Based-on-IoT-Bot/Assets/Documentation/Diagram/Workflow.jpg

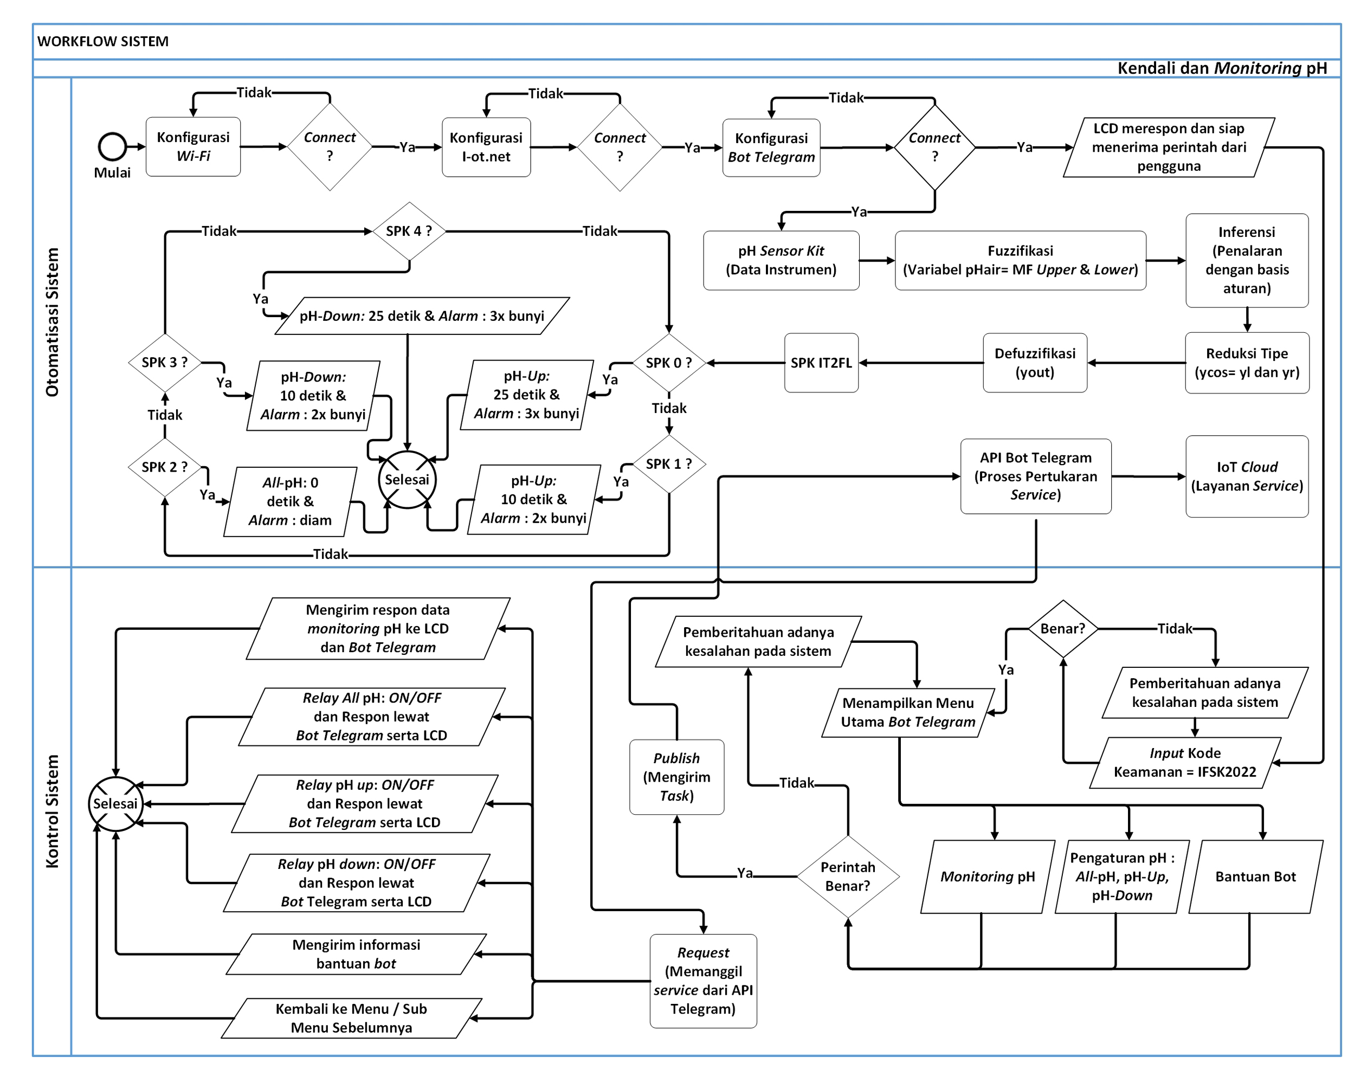
Assets/Documentation/Diagram/Workflow.jpg
